johnboiles/esp-roomba-mqtt/hardware/esp-roomba-mqtt.sch

## KiCad design hardware/esp-roomba-mqtt.sch (2018-10-31)

Schematic: esp-roomba-mqtt.sch

Parts:
J1: Mini-DIN-7
R1, R2, R3, R4, R6: 10K
R5: 5K
U1: ESP-12E
U2: VOLT_REG
