johnboiles/esp-roomba-mqtt/(threads)

Thread 1 (2017-09-12):

Suggestions for improvement of Readme

Landrash, 2017-09-12:
Suggest the following be added to the Readme.
 - Picture of setup.
 - [Schematic](http://fritzing.org/home/) of wiring.
 - Link to platforms where this can be used.

nunofgs, 2017-10-03:
I would love do this for my roomba. Can you upload wiring instructions?

bachulator, 2017-11-07:
It would be great to have those covered.

nunofgs, 2017-11-07:
I would also love a blog post or two on how you reverse engineered the roomba protocol.

Share the knowledge! :)

Adminius, 2017-11-08:
> I would also love a blog post or two on how you reverse engineered the roomba protocol.

http://www.robotappstore.com/files/KB/Roomba/Roomba_SCI_Spec_Manual.pdf

brubaked, 2018-07-18:
Even a labeled picture of your setup would be very helpful for those of us who are just starting out.

johnboiles, 2018-10-30:
@kg333 was kind enough to do the schematic!

Thread 2 (2017-12-05):

Failed to read sensor values from Roomba

bachulator, 2017-12-05:
Platform: Roomba 780
board: d1_mini
Used PlatformIO to build the code.
Start/stop/return_to_home seems to work just fine but unfortunately no telemetry. Connecting back to telnet debug port getting repeating:
(d) Failed to read sensor values from Roomba

Happy to provide any necessary information

Iture, 2017-12-21:
I have the same problem - Roomba 786p, NodeMCU. Commands work, telemetry doesn't. Looks like serial read times out.

andenmad, 2018-02-09:
hi

Anyone found a solution for this i expiriens same problem

Daigaard, 2018-03-13:
We have found that if you use an ESP8266 module (Eg: WEMOS D1 Mini or NODE MCU), with a 470 Ohm (or equivalent) resistor mounted on the TX pin, this resistor needs to be removed in order to get the sensor values to the ESP. As this resistor pull's the TX pin to 3.3V.

By removing this resistor you can no longer program the module trough USB.

mannkind, 2018-03-17:
For what it's worth, my Wemos D1 Mini couldn't read the Roomba sensors either. I found this snippet in an [iRobot Create 2 Doc](http://www.irobot.com/~/media/MainSite/PDFs/About/STEM/Create/Create_2_to_5V_Logic.pdf)

> In some cases, the drive strength of a Roomba TX line is not enough to drive the RX line of another board (for example, in some revisions of Arduino). In this case, a simple PNP transistor (2N2907A, 2N3906, or 2N4403, among others) can be used to provide enough “drive” for the Arduino.

I used a 2N3906 and following the circuit as described in the PDF; I can now read sensor values from the Roomba!

se4n01, 2018-07-05:
So instead of removing the 470O resistor you used the 2N3906? I tried adding it to the voltage divided RX/TX line and it did not work. Did you remove the voltage divider?

mannkind, 2018-07-05:
@se4n01 - I am not using a voltage divider, that's correct.

johnboiles, 2018-10-31:
I suspect this is a big reason the serial transmission seems unreliable.

johnboiles, 2018-10-31:
I'll try the 2N3906 thing in a couple days. Looks just as simple if not simpler to wire than the voltage divider.

se4n01, 2018-11-01:
keep us posted, the 2N3906 did not work for me sadly

johnboiles, 2018-11-01:
@se4n01 interesting thanks for the tip. Maybe the best route is to use a bidirectional level shifter and do this right. That way we can eliminate any uncertainty about voltage levels being the cause of issues. I think I have a couple of these laying around

https://www.sparkfun.com/products/12009

I’ll have to move to a wemos d1 mini or some other board with a 5v rail but that’s not the worst thing

mannkind, 2018-11-01:
It's unclear to me from @se4no1's post and I'm not an expert in this stuff, but the 2N3906 does require a resistor (~ 1-10k) between the base pin and the mcu pin.

johnboiles, 2018-11-05:
Cross-posting here. I tried the bidirectional level shifter and it did not work. I have no idea why it didn't. I wrote in a bit more detail about it [here](https://community.home-assistant.io/t/add-wifi-to-an-older-roomba/23282/91).

se4n01, 2018-11-07:
Hi guys, thanks for sharing that HA thread, it's very informative, thank you! Shame the level shifter did not work but I think it's for the best to use it anyway. I also in the end tried removing the 470Ohm resistor, it also did not work. I will try playing around with the code this weekend when I have some time. As an aside, NiMH batteries actually like to be deep discharged, partial discharging causes them to lose the memory of the zero and will reduce capacity with time.

johnboiles, 2018-11-07:
Interesting to know about the deep discharge. I think 10.8v is a deep-ish discharge for the roomba battery right?

dinkyshaw, 2018-12-09:
Hi folks, just sharing another data point for troubleshooting the Rx sensor issue. Thanks for writing the code! It's been a fun project so far (my first microcontroller project) but the lack of sensor data has been a disappointment.

I have it integrated with the [MQTT vacuum component](https://www.home-assistant.io/components/vacuum.mqtt/) in Home Assistant and can get it to respond to all commands over MQTT but it would be nice to have the battery level information to set up automations to send it back to dock to charge and then send it back out when it's done.

Platform: Roomba 400 series (model 4225)
board: NodeMCU LUA CP2102 ESP-12E
wiring diagram:
[https://drive.google.com/file/d/1tdn0-SuSc2DnK_XVjq6-IIlq8nxzRpOp/view?usp=sharing](url)

** I have also tried wiring with a logic level converter between the NodeMCU board and the Roomba on both Rx and Tx instead of using the PNP transistor (2N3906) and, like the PNP transistor wiring, can Tx to but not Rx from Roomba.

**platformio.ini** file:
```
[env:d1_mini]
platform = espressif8266
board = nodemcuv2
framework = arduino
lib_deps =
  RemoteDebug
  PubSubClient
  ArduinoJson

upload_port = roomba.local
build_flags = -DLOGGING=1 -DMQTT_MAX_PACKET_SIZE=512
```
I also had to set the baud rate to 57600 in the **main.ccp** file for the 400 series Roomba to respond to commands:
```
// Roomba setup
Roomba roomba(&Serial, Roomba::Baud57600);
```
I see no payload at all when monitoring the **'vacuum/state'** MQTT topic :(

I've also tried using the [Arduino sketch](https://github.com/thehookup/MQTT-Roomba-ESP01) written by the [The Hook Up in his Roomba setup](https://www.youtube.com/watch?v=t2NgA8qYcFI&t=381s) and, again, Roomba will respond to commands but I can't get sensor data.

Any ideas are greatly appreciated but mostly wanted to share my experience. Thanks again!

Armadill0, 2020-03-28:
@dinkyshaw Got my Roomba 780 perfectly working with this wiring: https://github.com/thehookup/MQTT-Roomba-ESP01/blob/master/schematic.JPG

Thread 3 (2018-02-07):

Deep sleep

AndiTheBest, 2018-02-07:
Hi,

any updates from preventing the roomba going to deep sleep, so the serial comm doesn't get disabled?
Same problem here :/

Apocrathia, 2018-06-12:
I've gotten the following code from Thinking Cleaner. Since their product is now EOL, they have been willing to share their source code.
```
void RoombaWakeOnDock(void) {
    ROOMBA_WAKE_LO();      // hardware wake pin on SCI conn
    DelayMs(50);
    ROOMBA_WAKE_HI();      // hardware wake pin on SCI conn
    DelayMs(80);
    RingBufferWrite(&txBuffer, OPCODE_CLEAN);    // write the CLEAN command code to the SCI port
    RingBufferWrite(&txBuffer, 0x10);
}
```
Unfortunately, I don't have a 650 to test this with. I hope this helps.

quazzie, 2018-07-03:
@Apocrathia got any more information ?
I tried sending this sequence every 50 seconds to keep the 650 awake but it starts the cleaning cycle.
I tried with both OPCODE_CLEAN = 136 and 135.

AndiTheBest, 2018-07-03:
I did it the following way:

When Roomba is in dock:
```
  pinMode(roomba_reset,OUTPUT);
  digitalWrite(roomba_reset,LOW); // start roomba
  delay(200);
  pinMode(roomba_reset,INPUT);
  delay(200);
  ROOSER.write(128); //start command
  delay(10);
  ROOSER.write(135); //CLEAN
  delay(150);
  ROOSER.write(143);//DOCK
```

When its not in dock and not cleaning:
```
  ROOSER.write(131);//SAFE MODE
  delay(300);
  ROOSER.write(130);//PASSIVE MODE
```

But its not working perfectly. The Roomba doesnt go to sleep mode and wastes much power when not in dock. And when the battery got drained, the Arduino is not able to establish a connection until I unplug and replug it.
The delays are important what i remember when implementing this. When you send the commands too fast, it won't recognize them i think.

quazzie, 2018-07-06:
Thanks @AndiTheBest
Seems to work :)

legomind, 2018-08-16:
Just wanted to say that the current wakeup code works great for the 860

johnboiles, 2018-10-30:
Great investigation @Apocrathia. I had also tried to reach out to Thinking Cleaner in the past but wasn't able to get ahold of them. I'm glad you were able to!

I'll give this a shot on my 650

johnboiles, 2018-10-30:
@Apocrathia did they share their whole source code or just this one bit?

Apocrathia, 2018-10-30:
@johnboiles That was the only snippet that they gave to me when I asked. I simply emailed their [thinkingcleanersales@thinkingbits.nl](mailto:thinkingcleanersales@thinkingbits.nl) address and asked if they would be willing to share how they accomplished it, as their product is EOL and they can no longer benefit from keeping the source code closed. I'm sure someone could convince them to release the rest of it.

johnboiles, 2018-10-31:
@AndiTheBest when you're changing `pinMode(roomba_reset,INPUT);` is that to make the pin high impedence?

johnboiles, 2018-10-31:
@Apocrathia's code from Thinking Cleaner definitely causes my Roomba to start cleaning. I'm also super curious what `RingBufferWrite(&txBuffer, 0x10)` is supposed to do. There's not anything in the docs about that command I don't think.

@AndiTheBest's code is working fine so far for me (only about 15 mins of testing at this point though). @AndiTheBest would you mind putting your full code on GitHub or submitting pull requests? You must have made some other changes to track the state of the roomba so that you can switch wakeup methods

AndiTheBest, 2018-11-02:
Sorry, i don't use the code of this project, as i've implemented my project on my own, using an Arduino Pro Micro with a HC-12 wireless transceiver.
Just here for exchanging experience ;)
I've set the Pin to Input instead of Output-High as the Roomba internally already has an Pullup. This is not necessary.

Just for infomation again: Every few weeks/months, the Roomba starts cleaning in the middle of the night, as i think it doesnt get the "DOCK" command after the "CLEAN" command (single serial communication fail). This is something that still needs to get prevented, but i didn't had time to play with my roomba the last few months :/

johnboiles, 2018-11-02:
It would still be interesting to see your code if you wouldn’t mind sharing! Maybe some other ideas we could learn!

johnboiles, 2018-11-10:
@AndiTheBest's fix has been working reliably for me for a week or so. I still occasionally have an issue where i need to send the `turn_on` command multiple times to get the roomba to start, but it's possible I need to wait more after pulsing the BRC pin to send commands.

johnboiles, 2018-11-20:
I got my first middle-of-the night roomba wake up last night and it sucked. I’m going to put some more effor into figuring out a better solution.

Tim3100, 2019-02-06:
Is there any update? I am super curious to get this running, but keeping the Roomba awake all the time and risking midnight cleaning does not sound perfect.

My main use-case would be to stop the Roomba from cleaning if somebody is at home. One alternative approach I was thinking about: I could use the schedule of the Roomba to initiate cleaning. If I could detect the start quickly enough, I could immediately send a stop command if someone is home. Any comments whether this could be feasible?

Tim3100, 2019-02-10:
I‘m now thinking about two other workarounds:
- using an IR LED and sending the cleaning command from remote (I hope the IR interface is not affected by deep sleep)
- adding a smart plug to the dock. I hope the Roomba wakes up if I deactivate the power to the dock. An automation, e.g., in Node Red would then first deactivate the power for a couple of seconds and then send the cleaning command.

johnboiles, 2019-02-10:
I disabled the 650 wakeup workaround (because I want to make sure not to get woken up again).

```diff
diff --git a/src/config.h b/src/config.h
index 9c26860..8c0b18f 100644
--- a/src/config.h
+++ b/src/config.h
@@ -2,10 +2,10 @@

 #define HOSTNAME "roomba" // e.g. roomba.local
 #define BRC_PIN 14
-#define ROOMBA_650_SLEEP_FIX 1
+//#define ROOMBA_650_SLEEP_FIX 1

 #define ADC_VOLTAGE_DIVIDER 44.551316985
//#define ENABLE_ADC_SLEEP

 #define MQTT_SERVER "10.0.0.2"
 #define MQTT_USER "homeassistant"
diff --git a/src/main.cpp b/src/main.cpp
index 586783c..048d615 100644
--- a/src/main.cpp
+++ b/src/main.cpp
@@ -449,8 +449,7 @@ void loop() {
       if (roombaState.docked) {
         wakeOnDock();
       } else {
-        // wakeOffDock();
-        wakeup();
+        wakeOffDock();
       }
     } else {
       wakeup();
```

And it actually still sorta seems to work. I just have to issue the `turn_on` command twice for the vacuum to come on. I'm wondering if moving to streaming values made it wakeup a little more easily somehow?

johnboiles, 2019-02-10:
But I'm confident that with some experimentation, whatever is causing it to still wake up after issuing the turn_on command twice, could be adapted into a full-blown fix.

KTibow, 2020-02-08:
You can solve multiple problems by using this:
```
roomba.write(135); // Clean
delay(10);
roomba.write(131); // Safe mode (stops cleaning job)
delay(50);
roomba.write(131); // Make sure roomba got safe mode command (prevents cleaning in the middle of the night
delay(50);
roomba.write(130); // Go back into normal mode
delay(50);
roomba.write(130); // Make sure roomba goes back into normal mode (so you don't have to pick roomba up in order to escape safe mode)
```
Namely, this code works off the dock and on the dock. The only downside is that it stops the roomba from cleaning, but so would the proposed solution for waking up the roomba off the dock:
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
I've been using this solution for my code with checking to see whether the roomba is cleaning (is the brush spinning or the right wheel moving), and it works great.

KTibow, 2020-02-11:
Update: Midnight cleaning problems, or in my case, mid-day. Anybody here have an idea to stop it from cleaning?

KTibow, 2020-02-14:
I ended up doing something like
```
if (docked) {
clean()
}
safeMode()
safeMode()
if (oiMode != safeMode) {
log("Midnight cleaning detected!")
closeConnection()
delay(1000)
openConnection()
safeMode()
safeMode()
passiveMode()
passiveMode()
closeConnection()
openConnection()if (docked) {
clean()
}
safeMode()
safeMode()
if (oiMode != safeMode) {
log("Midnight cleaning detected!")
closeConnection()
delay(1000)
openConnection()
safeMode()
safeMode()
passiveMode()
passiveMode()
closeConnection()
openConnection()
}
passiveMode()
passiveMode()
}
passiveMode()
passiveMode()
```
The weird thing is, when it starts cleaning, I can still issue the stop command and it'll stop. Might the past contributors want to help?

Thread 7 (2018-10-11):

MQTT message size limit

brainboutique, 2018-10-11:
After charging, MQTT stopped working. Reason: https://github.com/knolleary/pubsubclient has documented limit to 128b - this is apparently exceeded when voltage and charge have sufficient digits.

Workaround: Prepend
#define MQTT_MAX_PACKET_SIZE 256
before other includes or withing PubSubClient.h

johnboiles, 2018-10-31:
If you build via platformio you should get this automatically because of [this line](https://github.com/johnboiles/esp-roomba-mqtt/blob/master/platformio.ini#L21) in the platformio.ini file

`build_flags = -DLOGGING=1 -DMQTT_MAX_PACKET_SIZE=512`

PubSubClient.h isn't included in this repo so I think it's out of the scope to have it modified here. Wouldn't be bad to mention this in the README though. Feel free to submit a modification to the README

Closed 2018-10-31.

Thread 10 (2018-10-30):

TX and BRC

kriskirkland, 2018-10-30:
Device: Roomba 700 using ESP01
I have one problem and one question;
1) RX works fine I get all the sensor values but nothing happens when sending it any commands.

Question: Can I switch the BRC ping from GPIO15 to GPIO2 since the esp01 doesnt expose 15?

johnboiles, 2018-10-31:
Huh. To get sensor values you also need to send data over serial to tell the Roomba to send them, so that suggests to me that your TX to the Roomba works. What exactly do you mean by 'sending it any commands'? Are you posting to an mqtt topic?

You should be able to switch the BRC pin just fine. There's nothing special about that pin.

kriskirkland, 2018-10-31:
I guess what I should have said was that I can received sensor stats via the telnet debug interface but when i send a start command as referenced in the readme "mosquitto_pub -t 'vacuum/command' -h $MQTT_SERVER -p 1883 -u $MQTT_USER -P $MQTT_PASSWORD -V mqttv311 -m "turn_on"" nothing happens regardless if its on the dock or not. I have also tried to send it "return_to_base" while cleaning and it does nothing. It is publishing its stats to MQTT as well.

johnboiles, 2018-10-31:
OK so you can

    mosquitto_sub -t 'vacuum/state' -v -h $MQTT_SERVER -p 1883 -u $MQTT_USER -P $MQTT_PASSWORD -V mqttv311

And you get something like

    vacuum/state {"battery_level":100,"cleaning":false,"docked":true,"charging":true,"voltage":16894,"current":0,"charge":2214}

But you can't

    mosquitto_pub -t 'vacuum/command' -h $MQTT_SERVER -p 1883 -u $MQTT_USER -P $MQTT_PASSWORD -m 'turn_on' -V mqttv311 -r -q 0

That is strange. Do you see in the debug messages anything about receiving the command?

kriskirkland, 2018-11-01:
I found the problem, mosquitto_pub wouldn't work with the quotes on the command topic. IE: This doesnt work  `mosquitto_pub -t 'vacuum/command' -h $MQTT_SERVER -p 1883 -u $MQTT_USER -P $MQTT_PASSWORD -V mqttv311 -m "turn_on"`

But his does work:
`mosquitto_pub -t vacuum/command -h $MQTT_SERVER -p 1883 -u $MQTT_USER -P $MQTT_PASSWORD -V mqttv311 -m "turn_on"`

kriskirkland, 2018-11-01:
Client machine is Windows 10, broker is Debian 9.

Closed 2018-11-01.

Thread 12 (2018-11-12):

Wiring Scmatics for ESP 01

wranglatang, 2018-11-12:
Hello,

Would it be possible to post a wiring Scmatics & Config changes required for use with an ESP 01?

I seen another video online from The Hookup where Rob uses a PNP transistor and a buck converter. I’m wondering why you use all the resistors?

Apologies, my electronic knowledge is not great!

kntsoft, 2019-05-31:
Hi!
You can use this image from https://domology.es/domotizando-nuestra-vieja-roomba-serie-5-6-con-esp-01-y-mqtt/ I use it with sucessful. The model of transistor is PNP 2N3906
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

Remember change platformio.ini like
```
[env:esp01_1m]
platform = espressif8266
framework = arduino
board = esp01_1m
lib_deps =
  RemoteDebug
  PubSubClient
  ArduinoJson@^5.13.4
build_flags = -DLOGGING=1 -DMQTT_MAX_PACKET_SIZE=512

```
And  you can USE BRC_PIN as PIN 2

Closed 2021-07-31.

Thread 13 (2018-11-12):

Not Working after Upload to D1 Mini

wranglatang, 2018-11-12:
I have uploaded the code on a D1 Mini board and it doesn't appear to work.

If i monitor the serial out i can see
`--- Miniterm on /dev/cu.usbserial-1410  9600,8,N,1 ---
--- Quit: Ctrl+C | Menu: Ctrl+T | Help: Ctrl+T followed by Ctrl+H ---
,E����dGI�0lK��␄i�␞H␡����Ȍ!C����V)��3���T!��4�B�P�j���������������������������������\��������������������������������������޿��������������n���ʿ�������\��������������q��R8���d:w����␌!��␎��f闍␙���v��!�K��b��\�l�������������������������������\��T����������������ş�����������l�������ղ�����������ڱ����������������������������?3�b(��`;G������E�����)��7��!!�:�TD�j�����������d���������������������\�������������������������������������ڌ�������Ų��������?��������������������l�����u��V(�)�D
�������E���␙�ť�7�1!��*�␚����U�����������������������܍�������������������ʲ���g��������������������ݸ������������F�܌�������������������l�����u���)�D`

I also don't get any messages published to the MQTT Topic.

johnboiles, 2018-11-22:
Did you set the correct wifi credentials in secrets.h? Do you see the D1 Mini show up in your routers admin page? Can you `ping roomba.local` from your computer? That output just looks like you have the wrong baud rate set. Try 115200

egebaek, 2019-04-10:
have the same problem, cannot see it in the DHCP table, the Wifi credentials i correct, gets this from the Serial monitor on 115200:
sd[00]dœŸ|[00]„là|[03][04][04][0C]Œ[04]$ì[0C]b|‚[03]ä[1B]’s›cŒ[0C]bÄògnŸlgnœâä[04]b[1C]pŒŽdsd{lpûgà[10][03][0C][0C]ƒ[04]l[0C]„œ[0C][0C][04]c[0C]gã|[03]lì[04][04]‡c„ûogç[00]$ŒÇd`[03]Ø[13][1B]gg[04]$`[02][07][03]o;‡“›o[0C][0C]c[04]œ[0F]$[0F]{’“n[0C][0C]c[04]œ[0E]dœ[1B]l‡p[02]›ãâ[13]›`[02]ü‚gœ[03]

have this building log:
Processing d1_mini (platform: espressif8266; board: d1_mini; framework: arduino)

Verbose mode can be enabled via `-v, --verbose` option
CONFIGURATION: https://docs.platformio.org/page/boards/espressif8266/d1_mini.html
PLATFORM: Espressif 8266 > WeMos D1 R2 and mini
HARDWARE: ESP8266 80MHz 80KB RAM (4MB Flash)
Library Dependency Finder -> http://bit.ly/configure-pio-ldf

LDF MODES: FINDER(chain) COMPATIBILITY(soft)
Collected 33 compatible libraries
Scanning dependencies...
Dependency Graph
|-- <RemoteDebug> 1.5.8
|   |-- <ESP8266WiFi> 1.0
|-- <PubSubClient> 2.7
|-- <ArduinoJson> 5.13.4
|-- <Roomba>
|-- <ESP8266WiFi> 1.0
|-- <ArduinoOTA> 1.0
|   |-- <ESP8266WiFi> 1.0
|   |-- <ESP8266mDNS> 1.2
|   |   |-- <ESP8266WiFi> 1.0
|-- <ESP8266mDNS> 1.2
|   |-- <ESP8266WiFi> 1.0

Closed 2021-07-31.

Thread 14 (2019-01-06):

Roomba wakes up and restarts every 10 seconds

kaosrq, 2019-01-06:
When connecting the Nodemcu the roomba enters a loop that wakes it up (sound included) and after about 10 seconds it restarts and returns to do the same. I can have debug connection by telnet. But when sending a command I receive the disconnect message. When trying to press the buttons of the roomba, he receives the commands but executes them with these 10-second pauses. By executing a pin to the ip of the nodemcu, I check that the board restarts at that time. Test with 2 other plates and the result is the same. Even if the feed for usb restarts every 10 seconds.

kaosrq, 2019-01-06:
Checking the serial monitor gives me this:

Exception (0):
epc1=0x4000dce5 epc2=0x00000000 epc3=0x00000000 excvaddr=0x00000000 depc=0x00000000

ctx: cont
sp: 3ffffc60 end: 3fffffd0 offset: 01a0

>>>stack>>>
3ffffe00:  4000066d 9d438d71 000026fe 00000098
3ffffe10:  00000041 9d438d71 00000020 fffffffe
3ffffe20:  00000066 3fffc6fc 2c448d71 00985297
3ffffe30:  00418937 002d1666 3ffeffd4 00000030
3ffffe40:  0000001f 40104bf5 3ffefa6c 4020b96c
3ffffe50:  00000000 3ffefa6c 3ffefa6c 40203c02
3ffffe60:  4000050c 00000000 0000001f 40104bf5
3ffffe70:  4020bdc8 3ffffe80 000000c8 00000008
3ffffe80:  3ffffe70 00000000 00000001 00000000
3ffffe90:  3fffdab0 00000000 3fffd9d0 3ffeffd4
3ffffea0:  00000000 00000000 00000001 3ffe862c
3ffffeb0:  00000000 3fffdad0 3ffeffd4 00000030
3ffffec0:  00000000 000026e5 3ffeffd4 00000030
3ffffed0:  00000000 00000000 00000001 3ffeffcc
3ffffee0:  00000000 3fffdad0 3ffeffd4 00000030
3ffffef0:  40201d55 3fffc6fc 3ffefd54 4020b808
3fffff00:  00000000 4bc6a7f0 00002711 402064d0
3fffff10:  00000000 00000000 4bc6a7f0 00000000
3fffff20:  3ffefccc 00000064 4010663a 00000000
3fffff30:  00000000 00000015 3ffefa6c 40204a1b
3fffff40:  00000000 4bc6a7f0 00002711 3ffeffd4
3fffff50:  00000000 00000000 4bc6a7f0 00000000
3fffff60:  3fffdad0 3ffeffd4 4010663a 051eb851
3fffff70:  00000000 00000064 3ffefa6c 3ffefd30
3fffff80:  00002711 3ffefa6c 3ffefd54 40203ee4
3fffff90:  00000000 00000000 00000000 4020b5a0
3fffffa0:  00000000 00000000 00000001 3ffeffd4
3fffffb0:  3fffdad0 00000000 3ffeffcc 4020987c
3fffffc0:  feefeffe feefeffe 3ffe862c 40100721
<<<stack<<<

 ets Jan  8 2013,rst cause:2, boot mode:(3,6)

load 0x4010f000, len 1384, room 16
tail 8
chksum 0x2d
csum 0x2d
vbb28d4a3
~ld

ljmerza, 2019-01-10:
I get the same issue. Any help?

ljmerza, 2019-01-10:
my stack trace

`0x4020382c: loop() at C:\Users\Leo\Desktop\esp-roomba-mqtt-master\src/src.ino line 417
0x4020382c: loop() at C:\Users\Leo\Desktop\esp-roomba-mqtt-master\src/src.ino line 417
0x40208c3c: WiFiClient::operator bool() at C:\Users\Leo\AppData\Local\Arduino15\packages\esp8266\hardware\esp8266\2.5.0-beta2\libraries\ESP8266WiFi\src\WiFiClient.cpp line 350
0x401001c0: millis at C:\Users\Leo\AppData\Local\Arduino15\packages\esp8266\hardware\esp8266\2.5.0-beta2\cores\esp8266\core_esp8266_wiring.c line 183
0x40206c78: RemoteDebug::handle() at C:\Users\Leo\Documents\Arduino\libraries\RemoteDebug\RemoteDebug.cpp line 317
0x40208d40: Roomba::pollSensors(unsigned char*, unsigned char, unsigned char*) at C:\Users\Leo\Documents\Arduino\libraries\Roomba\Roomba.cpp line 279
0x401001c0: millis at C:\Users\Leo\AppData\Local\Arduino15\packages\esp8266\hardware\esp8266\2.5.0-beta2\cores\esp8266\core_esp8266_wiring.c line 183
0x402083f4: esp_yield() at C:\Users\Leo\AppData\Local\Arduino15\packages\esp8266\hardware\esp8266\2.5.0-beta2\cores\esp8266\core_esp8266_main.cpp line 91
0x40201546: delay at C:\Users\Leo\AppData\Local\Arduino15\packages\esp8266\hardware\esp8266\2.5.0-beta2\cores\esp8266\core_esp8266_wiring.c line 54
0x4020391c: loop() at C:\Users\Leo\Desktop\esp-roomba-mqtt-master\src/src.ino line 451
0x40202944: mqttCallback(char*, unsigned char*, unsigned int) at C:\Users\Leo\Desktop\esp-roomba-mqtt-master\src/src.ino line 136
0x40208ac4: std::_Function_base::_Base_manager ::_M_manager(std::_Any_data&, std::_Any_data const&, std::_Manager_operation) at c:\users\leo\appdata\local\arduino15\packages\esp8266\tools\xtensa-lx106-elf-gcc\2.5.0-3-20ed2b9\xtensa-lx106-elf\include\c++\4.8.2/functional line 1934
0x40208aac: std::_Function_handler ::_M_invoke(std::_Any_data const&, char*, unsigned char*, unsigned int) at c:\users\leo\appdata\local\arduino15\packages\esp8266\tools\xtensa-lx106-elf-gcc\2.5.0-3-20ed2b9\xtensa-lx106-elf\include\c++\4.8.2/functional line 2069
0x402084a0: loop_wrapper() at C:\Users\Leo\AppData\Local\Arduino15\packages\esp8266\hardware\esp8266\2.5.0-beta2\cores\esp8266\core_esp8266_main.cpp line 125`

kaosrq, 2019-01-14:
The problem seems to occur once you connect to the broker, loses the connection after showing this message:

```
 Debug: Command recevied: p
* Show profiler: On
(D p:^3698ms) Reconnecting MQTT
(D p:^0000ms) Attempting MQTT connection...
(D p:^0105ms) MQTT connected
```
If wrong MQTT data is configured (preventing it from connecting) the crash does not occur.

kaosrq, 2019-01-14:
The problem seems to arise in the function `void sendStatus()` . When assigning a fixed value to the line ` root["battery_level"] = (roombaState.charge * 100)/roombaState.capacity;`  The crash does not happen. Probably at some point `roombaState.capacity` is 0 and gives a division error by 0.

Mikei386, 2019-01-19:
I have exakt the same problem.
Had to delete the line to get it to work.
Now of course Home Assistant doesn't get a battery reading.

Using telnet to see the values, there are all there and stable.
Thinking about doing the math in Home Assistant to get the %.

Mikei386, 2019-01-19:
For now I'm using this "ghetto-fix":
I looked up the value for Capacity via telnet and substituted "roombaState.capacity;"

`  root["battery_level"] = (roombaState.charge * 100)/2696; `

I know the capacity will change over time but for now, I can get an estimate till the problem is fixed...

Daigaard, 2019-02-10:
Thanks for the post, this help me a bit further. Now my ESP (WeMos D1) is no longer rebooting.
But i only get empty values in my MQTT status. :
{"battery_level":0,"cleaning":false,"docked":false,"charging":false,"voltage":0,"current":0,"charge":0}
And it is only send once.

When i log into the ESP using Telnet, and set VERBOSE logging i get valid data:
(V t:84011ms) Got Packet of len=17! Distance:0mm ChargingState:4 Voltage:14416mV Current:-203mA Charge:2687mAh Capacity:2696mAh

Any help on how get the data send to MQTT broker?

Steffen

johnboiles, 2019-02-10:
Sounds like we should just put an `if` check if `roombaState.capacity` is 0 so we don't divide by 0 (what @kaosrq said). Not sure if that will solve all of the problems in this thread but can't hurt.

Daigaard, 2019-02-11:
Problem Solvej: The MQTT string (when populated with values) was longer than the default setting of 128 In the MQTT library. When I changed the value to 256 I started getting MQTT statuses send to the broker.
**Next challenge:**
Battery was drained from testing, when I placed roomba in charger, it stopped responding and I could not ping it😧. This project just won’t let me move on....
Well guess it’s a Hardware problem, this I should be able to solve on my own...😀

ljmerza, 2019-05-05:
did you change `MQTT_MAX_PACKET_SIZE` to fix this?

Thread 20 (2019-05-13):

Roomba 770 Responds to clean message, but no others.

zombielinux, 2019-05-13:
I've got this "working" on my Roomba 770.

I had to make some changes where ArduinoJSON got version incremented and broke a few things.

The side effect seems to be that the roomba wakes up and cleans randomly and stops responding over mqtt. I suspect its crashing, but the telnet interface never goes down or stops responding.

zombielinux, 2019-05-15:
It seems that if it is on the dock, and charging completes, it will turn itself on and start cleaning. If I continually post "return_to_base" every minute, it seems to stay put.

Thread 23 (2019-06-05):

Debug mode keeps disconnecting

2sheds, 2019-06-05:
Roomba 780
PLATFORM: Espressif 8266 > WeMos D1 R2 and mini
HARDWARE: ESP8266 80MHz 80KB RAM (4MB Flash)
BRC is on GPIO14 (marked as D5 on Wemos)
Compiled with PlatformIO (had to fix ArduinoJSON to v5), WiFi and MQTT connections seemingly work but debug terminal keeps disconnecting (tried telnet, nc and websocket - same behavior). Pings to the ESP continue to return with no interruptions.

I suspect that this may have other symptoms as it responds to incoming MQTT commands but it feels as if it hangs waiting for response from Roomba - first command is executed but consecutive ones are seemingly not processed until it times out.
Another symptom which may confirm lack of response is the status message:
> Reporting packet Distance:0mm ChargingState:0 Voltage:0mV Current:0mA Charge:0mAh Capacity:0mAh

2sheds, 2019-06-08:
I was able to overcome this by commenting out `sendStatus()` function call as roombaState can't be parsed due to aforementioned lack of response - this way I can still issue the commands to Roomba and telnet session doesn't disconnect every few seconds.

Closed 2019-06-08.

Thread 25 (2019-07-09):

build problem

pilot1981, 2019-07-09:
Hi,
using suggested Visual studio Code, I obtain this error during build task:

src/main.cpp:1:10: fatal error:
      'Arduino.h' file not found
#include <Arduino.h>

I need to download libraries from other repository?

mrgluek, 2019-07-09:
did your set your board in platformio.ini? (`[env:...]`)
also i need to change `lib_deps` to:
```
lib_deps =
  RemoteDebug
  PubSubClient
  ArduinoJson@~5.13.4,!=6```

pilot1981, 2019-07-11:
yes, I tried to setup "esp01" board....

so I need to wait your change in code in GitHub?

pilot1981, 2019-07-11:
today, I tried to use arduino IDE v.1.8.9 and build command return this error:

Arduino:1.8.9 (Mac OS X), Scheda:"Generic ESP8266 Module, 80 MHz, Flash, Disabled, All SSL ciphers (most compatible), ck, 26 MHz, 40MHz, QIO (fast), 512K (no SPIFFS), 2, nonos-sdk 2.2.1 (legacy), v2 Lower Memory, Disabled, None, Only Sketch, 115200"

main:408:11: error: StaticJsonBuffer is a class from ArduinoJson 5. Please see arduinojson.org/upgrade to learn how to upgrade your program to ArduinoJson version 6
   StaticJsonBuffer<200> jsonBuffer;
           ^
exit status 1
StaticJsonBuffer is a class from ArduinoJson 5. Please see arduinojson.org/upgrade to learn how to upgrade your program to ArduinoJson version 6

Questo report potrebbe essere più ricco di informazioni abilitando l'opzione
"Mostra un output dettagliato durante la compilazione"
in "File -> Impostazioni"

mrgluek, 2019-07-11:
Here's the fix:
https://github.com/johnboiles/esp-roomba-mqtt/pull/26/commits/fb7fc07b708dd024e75ee172a91aabc4c67604de

Thread 27 (2019-07-19):

Problems installing on ESP01

chmadkk, 2019-07-19:
Hi.

Ive tried uploading it to an Wemos D1 mini..

And connected it. But i get nothing in MQTT. Not even the hello message.. First time using Platform IO.

Tried uploading to an ESP01 instead.. This does not work either.

What is the correct schematic for using the wemos D1 mini. The Schematics seems to show some of the internal resistors also

Closed 2019-07-20.

Thread 28 (2019-07-20):

Not Compatible with the newest hass.io integration

chmadkk, 2019-07-20:
Im having a great deal of problems getting this integrated.
The legacy MQTT Vacuum is going to be removed. So im trying to switch to the newest state driven object.

I just cant figure out howto get this script to report the right format.

Thread 35 (2019-11-03):

Readme.md Electronics picture, GPIO 15 wrong

bks29b, 2019-11-03:
In readme.md the Electronics picture is wrong.
Connection "ESP GPIO15 -> 10kOhm Resistor -> GND" is not there. Instead there ist a connection of GPIO14 to GND.

Jancis, 2020-01-02:
Something like this?
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

PvdGulik, 2021-08-25:
So is the drawing or the reader.md wrong?

Should it be:

ESP GPIO15 -> 10kOhm Resistor -> GND
&
ESP GPIO14 -> Roomba BRC (Pin5 on Roomba)

**or**

Roomba BRC (Pin5 on Roomba) -> GPIO14 -> 10kOhm -> GND

Thanks!

Thread 41 (2021-03-15):

D1 Mini restarting every 11 seconds

kayaozalp, 2021-03-15:
Once flashed, D1 mini is restarting every 11 seconds.

When connected through telnet to the device, last message shows it is trying to connect to MQTT server before telnet connection is lost
```
* Please type the command and press enter to execute.(? or h for this help)
***
v
* Debug: Command received: v
* Debug level set to Verbose
(D) Reconnecting MQTT
(D) Attempting MQTT connection...
(D) MQTT connected
```

This issue occurs both right after flashing a new D1Mini, as well as when it is connected to Roomba.

No MQTT status updates observed with vacuum/#

Below the platformio.ini
```
[env:d1_mini]
platform = espressif8266
board = d1_mini
framework = arduino
lib_deps =
	RemoteDebug
	PubSubClient
	ArduinoJson@~5.13.4,!=6
upload_port = COM3
build_flags = -DLOGGING=1 -DMQTT_MAX_PACKET_SIZE=512
```

and config.h
```
#include "secrets.h"

#define HOSTNAME "roomba555" // e.g. roomba.local
#define BRC_PIN 14
#define ROOMBA_650_SLEEP_FIX 1

#define ADC_VOLTAGE_DIVIDER 44.551316985
//#define ENABLE_ADC_SLEEP

#define MQTT_SERVER "192.168.1.1"
#define MQTT_USER "********"
#define MQTT_COMMAND_TOPIC "vacuum/command"
#define MQTT_STATE_TOPIC "vacuum/state"
```

Closed 2021-03-16.

Thread 42 (2024-12-16):

Future maintenance & ESP32?

aly-fly, 2024-12-16:
Hi, is this project still maintained? I see useful pull requests being ignored and last commits done in 2019.
I have my [own version](https://github.com/aly-fly/Roomba-ESP32-MQTT-SmartNest-WebServer) of MQTT Roomba from long ago. Now I am looking to upgrade my Roombas with a better HA support and this project looks promising. I would adjust it to run also on ESP32. I am willing to contribute here, but if this is abandoned, I will rather make my copy...

iago-veiga, 2024-12-27:
Hi! I'm not entirely sure, but as you can see from the open and closed PRs, the last contribution was in 2019.

If you decide to work on something, let me know, and I’ll try to help.

There’s a discontinued project that used ESPHome, in case it’s helpful: https://github.com/mannkind/ESPHomeRoombaComponent

aly-fly, 2024-12-29:
Thanks for the feedback. I also found that repo and a few others. EspHome is good because it automatically adds a Device and Entities to HA. For MQTT system it's either fully manual or you have to implement the HA Discovery messages. Lots of precise work in any case.
I will pick one of the working EspHome repositories and upgrade that one.

Closed 2024-12-29.
