johnboiles/esp-roomba-mqtt/(commit log)

2017-09-09 Fix os_timer_setfn with c++ lambda breaks telnet on the 6th iteration
    [main.cpp]
2018-08-04 Update BRC Pin in README.md
    BRC is on GPIO14 (https://github.com/johnboiles/esp-roomba-mqtt/blob/master/src/config.h#L4) in the included ```config.h```.
    Additionally, 3.3v to RST is not required for normal operation, only if you need to hard reset the board, which you run RST to ground instead of high.
2018-10-05 Adding schematic
2018-10-05 Adding license for ESP-12E symbol just in case
2018-10-23 Fixing typo in main.cpp and Roomba.h
    [main.cpp]
2018-10-31 Adding KiCAD 5.0.0 sources for schematic in README. Schematic symbol is from kicad-ESP8266 by J. Dunmire under CCASA4.0.
    Updating schematic to reflect GPIO change in #5.
    [esp-roomba-mqtt.sch]
2018-11-02 Prototype code to sleep the ESP on low voltage
2018-11-09 Support for streamed sensor values. More resilient main loop logic.
2018-11-09 Try to re-request the sensor stream if we get stuck for 2 minutes
    [main.cpp]
2018-11-09 Fix stream command in Roomba.cpp library
    [main.cpp]
2018-11-11 Try using signed for charge since it seems to underflow
2019-02-10 Fixing compiler warning (#18)
    [main.cpp]
