johnboiles/esp-roomba-mqtt/(notices)

Notices in the files:
README.md:
[esp-roomba-mqtt schematic. ESP-12E symbol by J. Dunmire in kicad-ESP8266. is licensed under the Creative Commons Attribution-ShareAlike 4.0 International License. To view a copy of this license visit http://creativecommons.org/licenses/by-sa/4.0/](doc/schematic.png)
